joelspadin/NumBLE/case/renders/keyboard-layout.png

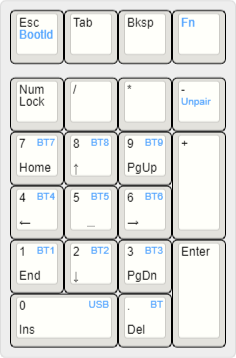
case/renders/keyboard-layout.png
