joelspadin/NumBLE/case/Case Bottom.stl

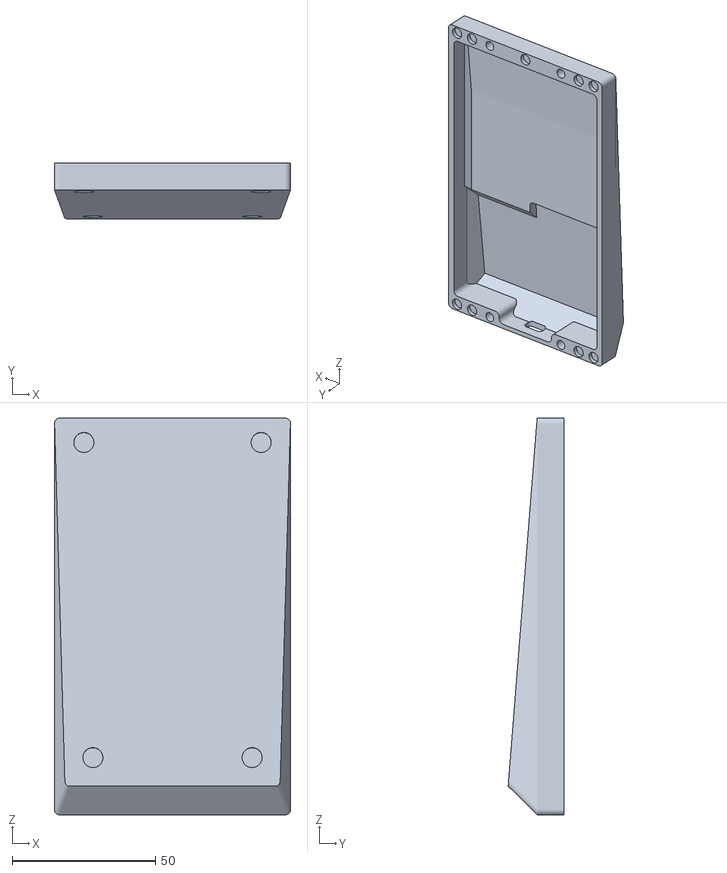
[picture p5: CAD file, 2021-05-31]
case/Case Bottom.stl
82.3 x 19.4 x 138.4
