joelspadin/NumBLE/case/Case Top.stl

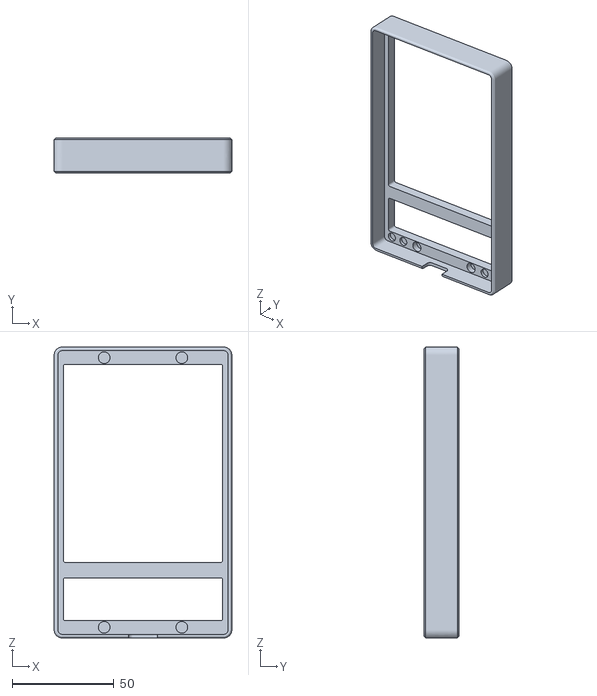
[picture p6: CAD file, 2021-05-31]
case/Case Top.stl
87.2 x 17.0 x 142.8
