joelspadin/NumBLE/case/Plate.dxf

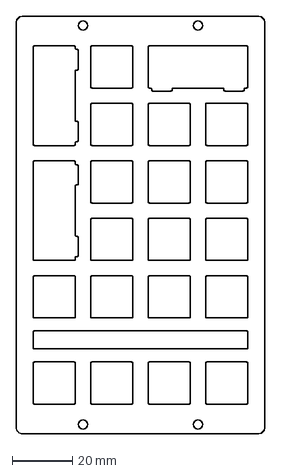
[picture p7: CAD file, 2021-05-31]
case/Plate.dxf
82.3 x 138.4 mm
