joelspadin/NumBLE/pcb/NumBLE.kicad_pcb

## KiCad design pcb/NumBLE.kicad_pcb (2021-05-31)

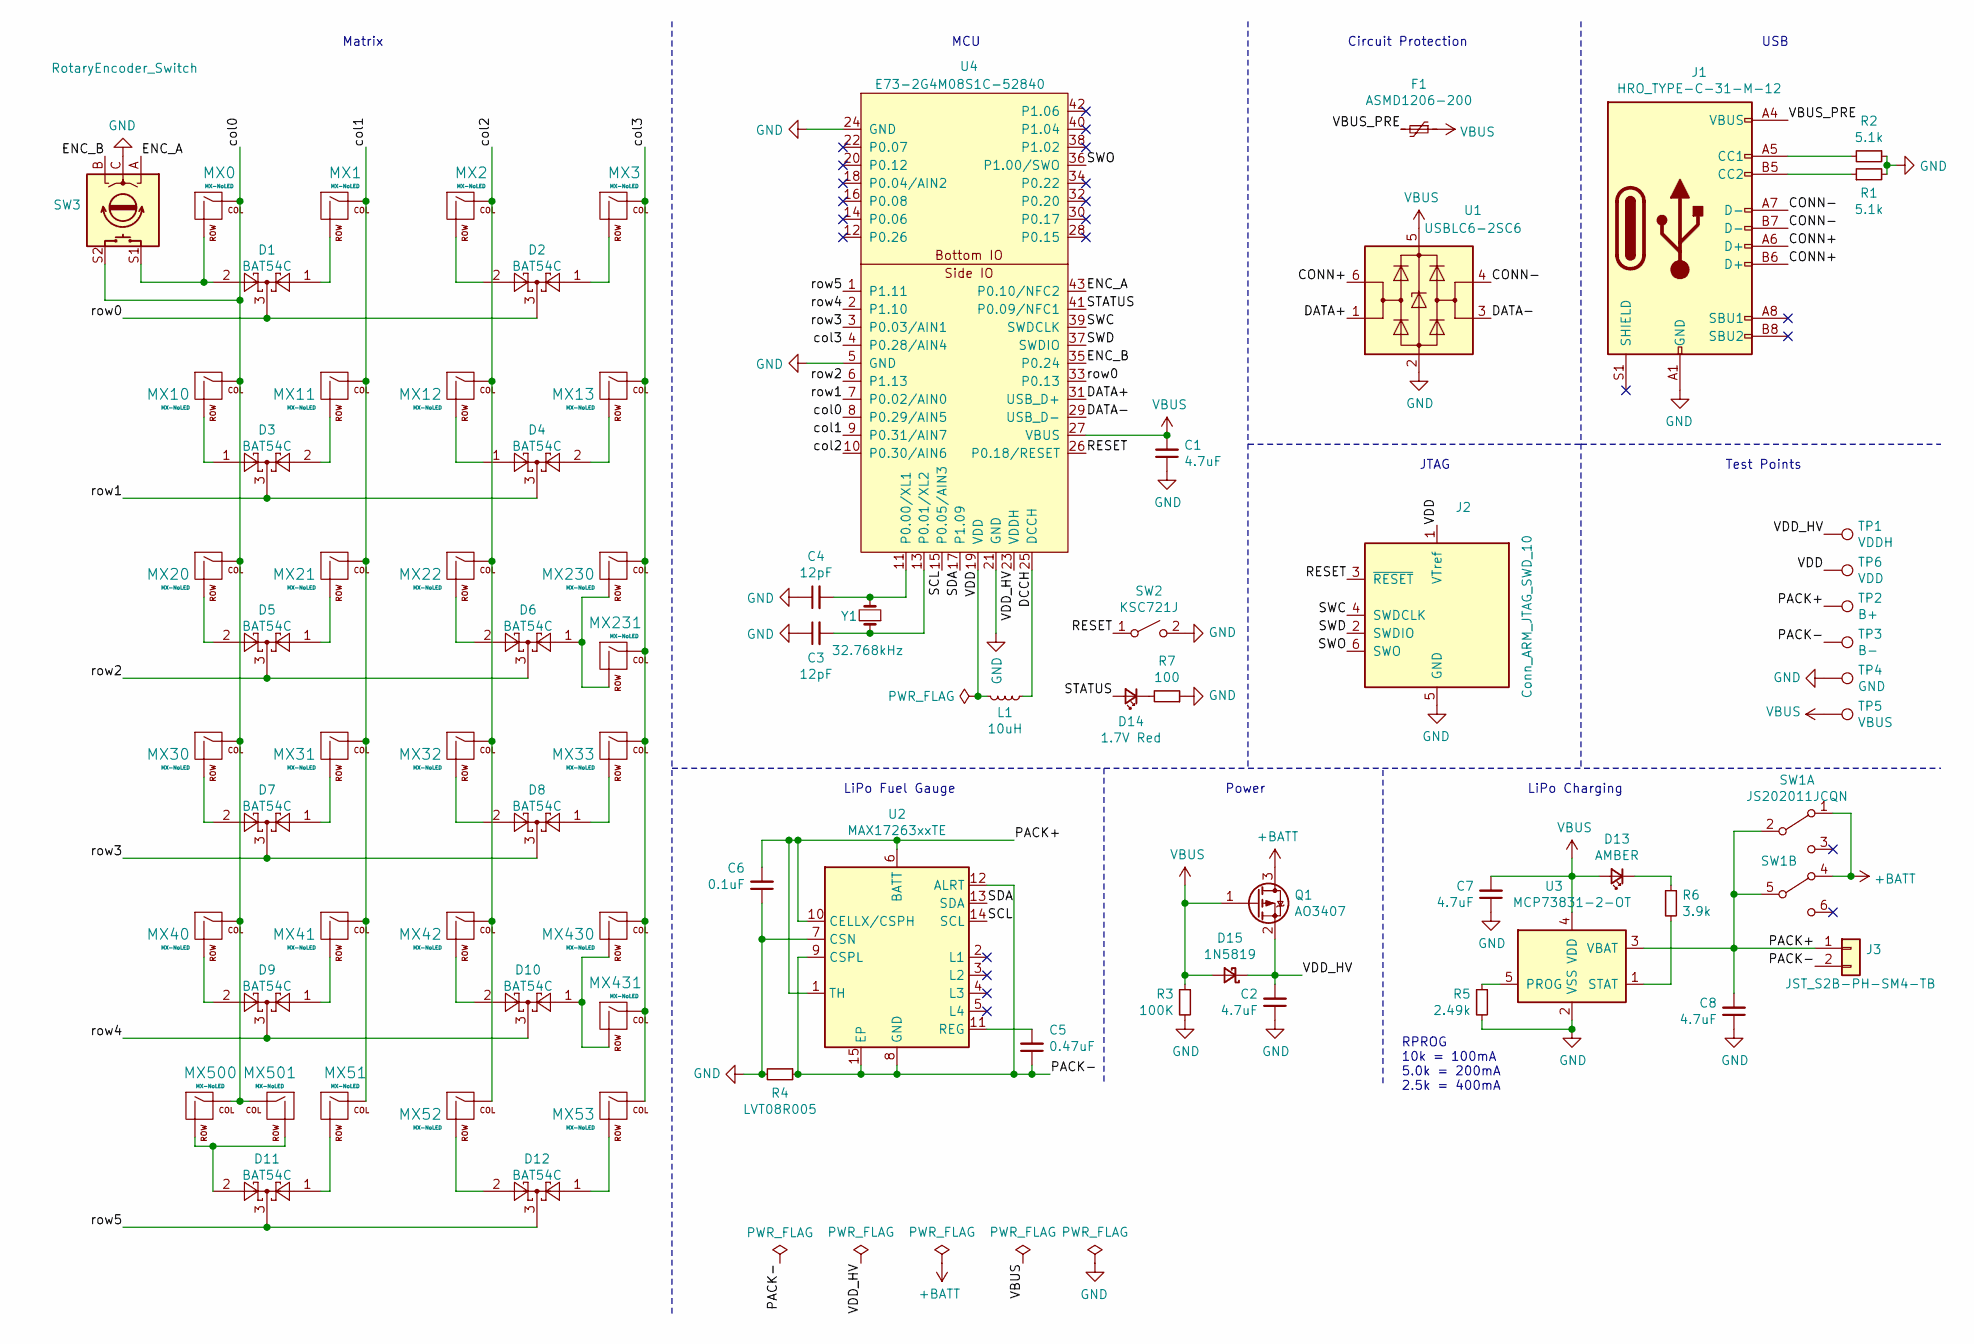
[picture p8: schematic NumBLE.kicad_sch]

Parts:
C1, C2, C7, C8: 4.7uF; C_0603_1608Metric_Pad1.08x0.95mm_HandSolder
C3, C4: 12pF; C_0603_1608Metric_Pad1.08x0.95mm_HandSolder
C5: 0.47uF; C_0603_1608Metric_Pad1.08x0.95mm_HandSolder
C6: 0.1uF; C_0603_1608Metric_Pad1.08x0.95mm_HandSolder
D1, D2, D3, D4, D5, D6, D7, D8, D9, D10, D11, D12: BAT54C; SOT-23
D13: AMBER; LED_0603_1608Metric
D14: 1.7V Red; LED_0603_1608Metric
D15: 1N5819; D_SOD-323_HandSoldering
F1: ASMD1206-200; Fuse_0805_2012Metric_Pad1.15x1.40mm_HandSolder
J1: HRO_TYPE-C-31-M-12; USB_C_Receptacle_HRO_TYPE-C-31-M-12
J2: Conn_ARM_JTAG_SWD_10; Tag-Connect_TC2030-IDC-NL_2x03_P1.27mm_Vertical
J3: JST_S2B-PH-SM4-TB; JST_PH_S2B-PH-SM4-TB_1x02-1MP_P2.00mm_Horizontal
L1: 10uH; L_0603_1608Metric_Pad1.05x0.95mm_HandSolder
MX0, MX1, MX2, MX3, MX10, MX11, MX12, MX13, MX20, MX21, MX22, MX30, MX31, MX32, MX33, MX40, MX41, MX42, MX52, MX53, MX230, MX430: MX-NoLED; MXOnly-1U-NoLED
MX51: MX-NoLED; MXOnly-1U-2U-Right
MX231, MX431: MX-NoLED; MXOnly-2U-ReversedStabilizers-NoLED
MX500: MX-NoLED; MXOnly-1U-2U-Left
MX501: MX-NoLED; MXOnly-1U-2U-Center-ReversedStabilizers
Q1: AO3407; SOT-23
R1, R2: 5.1k; R_0603_1608Metric_Pad0.98x0.95mm_HandSolder
R3: 100K; R_0603_1608Metric_Pad0.98x0.95mm_HandSolder
R4: LVT08R005; LVT08Rxxx0xER
R5: 2.49k; R_0603_1608Metric_Pad0.98x0.95mm_HandSolder
R6: 3.9k; R_0603_1608Metric_Pad0.98x0.95mm_HandSolder
R7: 100; R_0603_1608Metric_Pad0.98x0.95mm_HandSolder
SW1: JS202011JCQN; SW_DPDT_CK_JS202011JCQN
SW2: KSC721J; SW_Push_1P1T_NO_CK_KSC7xxJ
SW3: RotaryEncoder_Switch; RotaryEncoder_Alps_EC11E-Switch_Vertical_H20mm
TP1: VDDH; TestPoint_Pad_D1.5mm
TP2: B+; TestPoint_Pad_D1.5mm
TP3: B-; TestPoint_Pad_D1.5mm
TP4: GND; TestPoint_Pad_D1.5mm
TP5: VBUS; TestPoint_Pad_D1.5mm
TP6: VDD; TestPoint_Pad_D1.5mm
U1: USBLC6-2SC6; SOT-23-6
U2: MAX17263xxTE; DFN-14-1EP_3x3mm_P0.4mm_EP1.78x2.35mm
U3: MCP73831-2-OT; SOT-23-5
U4: E73-2G4M08S1C-52840
Y1: 32.768kHz; Crystal_SMD_3215-2Pin_3.2x1.5mm

Connections:
+BATT: Q1.3 (D), SW1.1 (A), SW1.4 (A)
/CONN+: J1.A6 (D+), J1.B6 (D+), U1.6 (I/O1)
/CONN-: J1.A7 (D-), J1.B7 (D-), U1.4 (I/O2)
/DATA+: U1.1 (I/O1), U4.31 (USB_D+)
/DATA-: U1.3 (I/O2), U4.29 (USB_D-)
/DCCH: L1.1, U4.25 (DCCH)
/ENC_A: SW3.A, U4.43 (P0.10/NFC2)
/ENC_B: SW3.B, U4.35 (P0.24)
/PACK+: C6.2, C8.2, J3.1, SW1.2 (B), SW1.5 (B), TP2.1, U2.1 (TH), U2.6 (BATT), U2.10 (CELLX/CSPH), U3.3 (VBAT)
/PACK-: C5.1, J3.2, R4.1, TP3.1, U2.8 (GND), U2.9 (CSPL), U2.12 (ALRT), U2.15 (EP)
/RESET: J2.3 (~RESET~), SW2.1 (A), U4.26 (P0.18/RESET)
/SCL: U2.14 (SCL), U4.15 (P0.05/AIN3)
/SDA: U2.13 (SDA), U4.17 (P1.09)
/STATUS: D14.2 (A), U4.41 (P0.09/NFC1)
/SWC: J2.4 (SWDCLK), U4.39 (SWDCLK)
/SWD: J2.2 (SWDIO), U4.37 (SWDIO)
/SWO: J2.6 (SWO), U4.36 (P1.00/SWO)
/VBUS_PRE: F1.2, J1.A4 (VBUS), J1.A9 (VBUS), J1.B4 (VBUS), J1.B9 (VBUS)
/VDD: J2.1 (VTref), L1.2, TP6.1, U4.19 (VDD)
/VDD_HV: C2.2, D15.1 (K), Q1.2 (S), TP1.1, U4.23 (VDDH)
/col0: MX0.1 (COL), MX10.1 (COL), MX20.1 (COL), MX30.1 (COL), MX40.1 (COL), MX500.1 (COL), MX501.1 (COL), SW3.S2, U4.8 (P0.29/AIN5)
/col1: MX1.1 (COL), MX11.1 (COL), MX21.1 (COL), MX31.1 (COL), MX41.1 (COL), MX51.1 (COL), U4.9 (P0.31/AIN7)
/col2: MX2.1 (COL), MX12.1 (COL), MX22.1 (COL), MX32.1 (COL), MX42.1 (COL), MX52.1 (COL), U4.10 (P0.30/AIN6)
/col3: MX3.1 (COL), MX13.1 (COL), MX33.1 (COL), MX53.1 (COL), MX230.1 (COL), MX231.1 (COL), MX430.1 (COL), MX431.1 (COL), U4.4 (P0.28/AIN4)
/row0: D1.3, D2.3, U4.33 (P0.13)
/row1: D3.3, D4.3, U4.7 (P0.02/AIN0)
/row2: D5.3, D6.3, U4.6 (P1.13)
/row3: D7.3, D8.3, U4.3 (P0.03/AIN1)
/row4: D9.3, D10.3, U4.2 (P1.10)
/row5: D11.3, D12.3, U4.1 (P1.11)
GND: C1.1, C2.1, C3.1, C4.1, C6.1, C7.1, C8.1, J1.A1 (GND), J1.A12 (GND), J1.B1 (GND), J1.B12 (GND), J2.5 (GND), R1.2, R2.1, R3.2, R4.2, R5.2, R7.1, SW2.2 (B), SW3.C, TP4.1, U1.2 (GND), U2.7 (CSN), U3.2 (VSS), U4.5 (GND), U4.21 (GND), U4.24 (GND)
unnamed: C3.2, U4.13 (P0.01/XL2), Y1.1
unnamed: C4.2, U4.11 (P0.00/XL1), Y1.2
unnamed: C5.2, U2.11 (REG)
unnamed: D1.1, MX1.2 (ROW)
unnamed: D1.2, MX0.2 (ROW), SW3.S1
unnamed: D2.1, MX3.2 (ROW)
unnamed: D2.2, MX2.2 (ROW)
unnamed: D3.1, MX10.2 (ROW)
unnamed: D3.2, MX11.2 (ROW)
unnamed: D4.1, MX12.2 (ROW)
unnamed: D4.2, MX13.2 (ROW)
unnamed: D5.1, MX21.2 (ROW)
unnamed: D5.2, MX20.2 (ROW)
unnamed: D6.1, MX230.2 (ROW), MX231.2 (ROW)
unnamed: D6.2, MX22.2 (ROW)
unnamed: D7.1, MX31.2 (ROW)
unnamed: D7.2, MX30.2 (ROW)
unnamed: D8.1, MX33.2 (ROW)
unnamed: D8.2, MX32.2 (ROW)
unnamed: D9.1, MX41.2 (ROW)
unnamed: D9.2, MX40.2 (ROW)
unnamed: D10.1, MX430.2 (ROW), MX431.2 (ROW)
unnamed: D10.2, MX42.2 (ROW)
unnamed: D11.1, MX51.2 (ROW)
unnamed: D11.2, MX500.2 (ROW), MX501.2 (ROW)
unnamed: D12.1, MX53.2 (ROW)
unnamed: D12.2, MX52.2 (ROW)
unnamed: D13.1 (K), R6.1
unnamed: D14.1 (K), R7.2
unnamed: J1.A5 (CC1), R2.2
unnamed: J1.B5 (CC2), R1.1
unnamed: R5.1, U3.5 (PROG)
unnamed: R6.2, U3.1 (STAT)
VBUS: C1.2, C7.2, D13.2 (A), D15.2 (A), F1.1, Q1.1 (G), R3.1, TP5.1, U1.5 (VBUS), U3.4 (VDD), U4.27 (VBUS)

Notes on the sheet:
Matrix
LiPo Fuel Gauge
MCU
Power
Circuit Protection
RPROG 10k = 100mA 5.0k = 200mA 2.5k = 400mA
JTAG
LiPo Charging
Test Points
USB

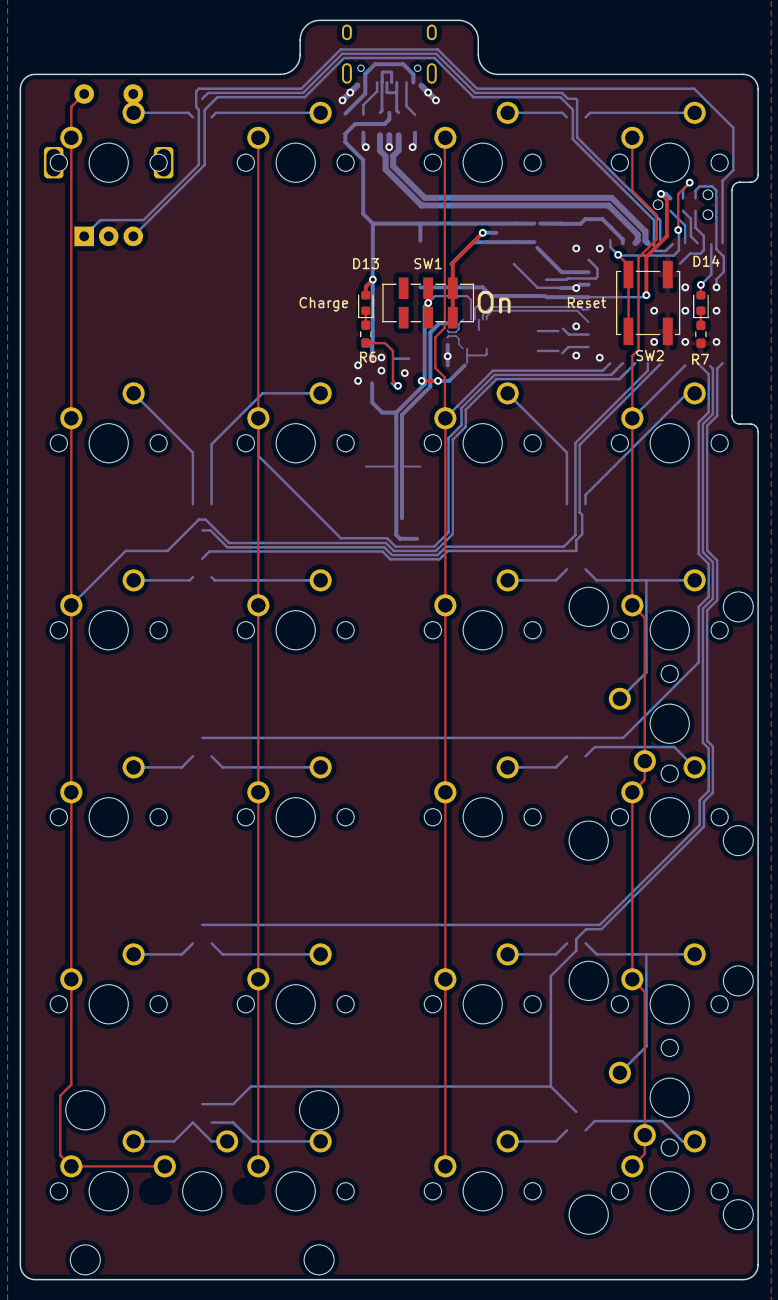
[picture p9: board NumBLE.kicad_pcb from above]

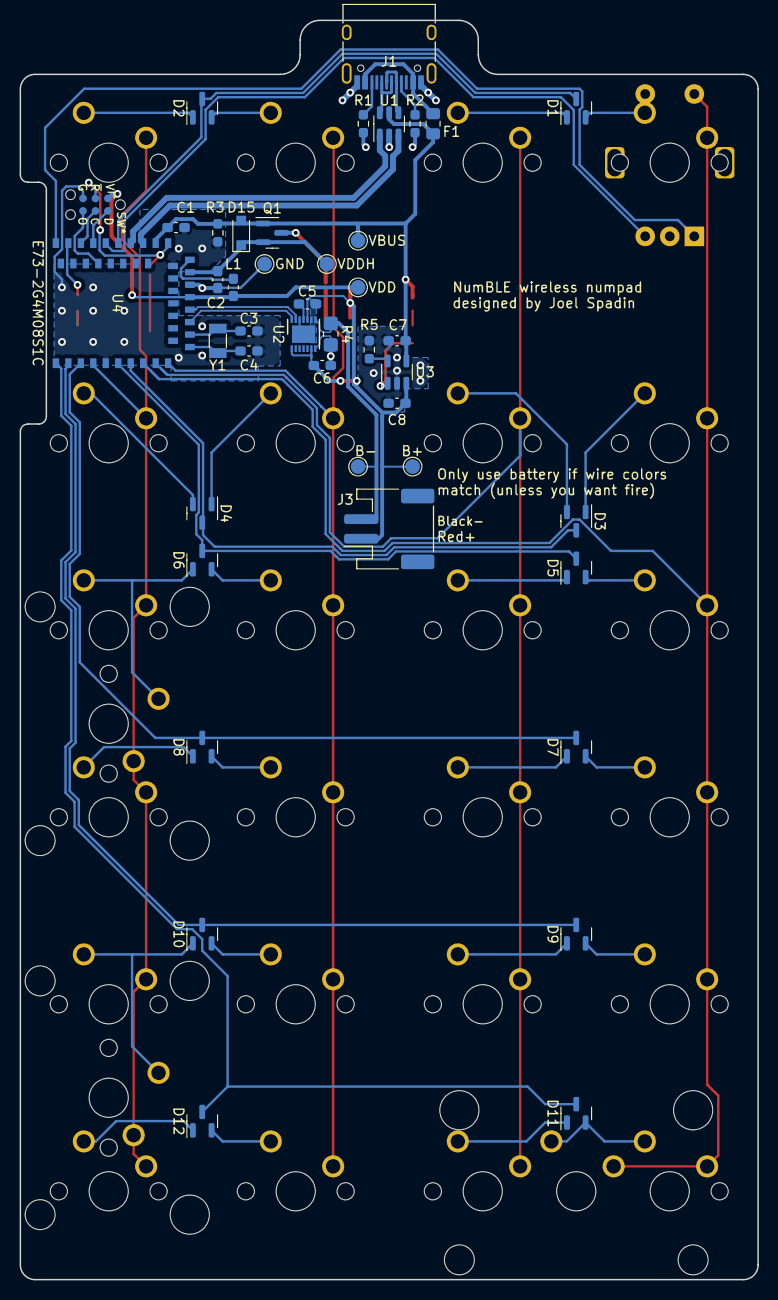
[picture p10: board NumBLE.kicad_pcb from below]

Board: 2 copper layers, 75.2 x 128.3 mm, 77 parts (43 on the bottom side), 65 nets.
