joelspadin/NumBLE/case/renders/Assembly-Bottom.gif

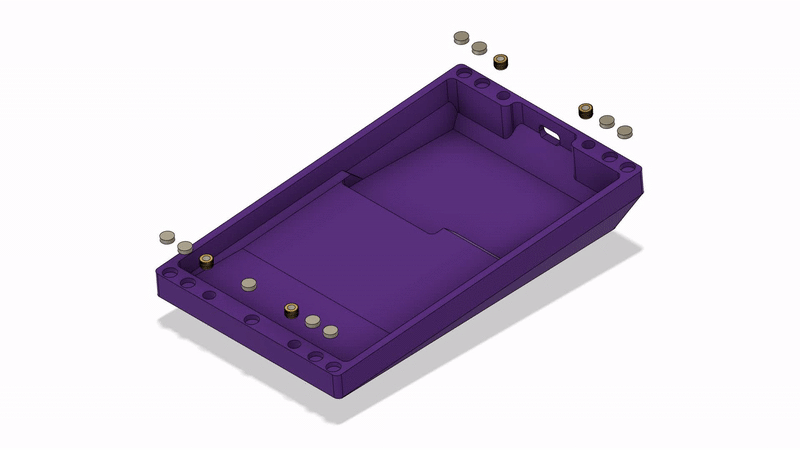
case/renders/Assembly-Bottom.gif
