joelspadin/NumBLE/case/renders/Assembly-Bumpons.gif

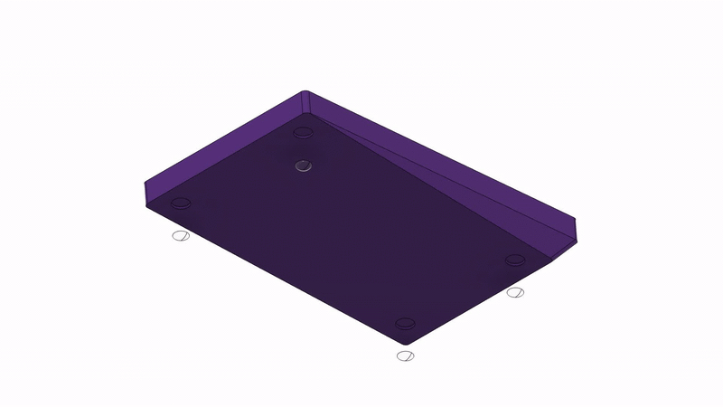
case/renders/Assembly-Bumpons.gif
