joelspadin/NumBLE/case/renders/Assembly-Switches.gif

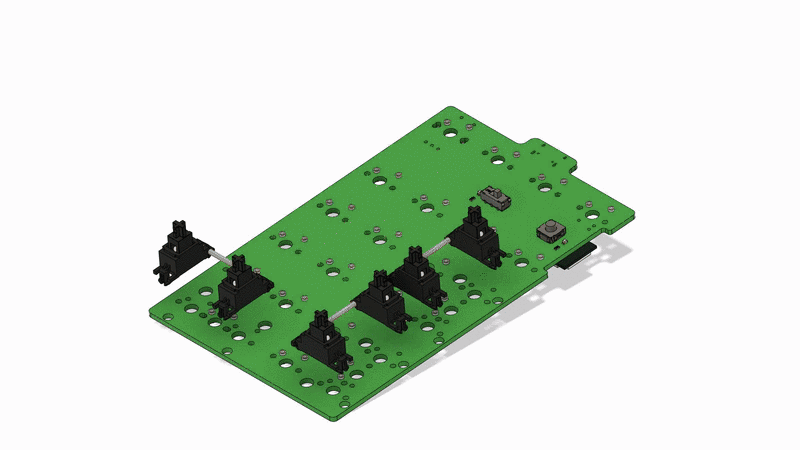
case/renders/Assembly-Switches.gif
