joelspadin/NumBLE/case/renders/Assembly-Top.gif

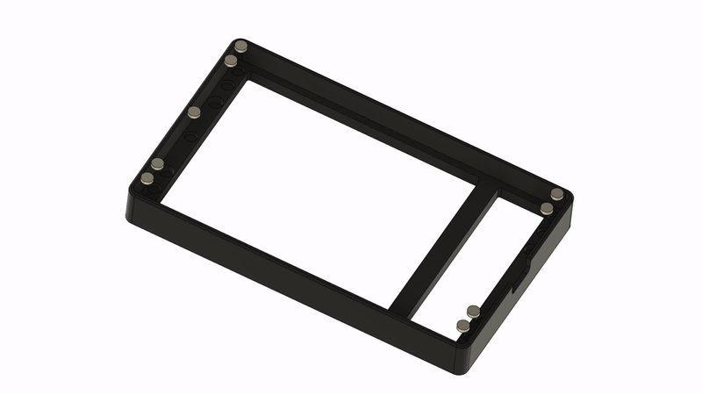
case/renders/Assembly-Top.gif
