joelspadin/NumBLE/(commit log)

2021-05-31 Move PCB files into subdirectory
    [NumBLE.kicad_pcb, NumBLE.kicad_sch]
2021-05-31 Add case files
    [Case Bottom.stl, Case Top.stl, Plate.dxf]
2021-05-31 Fix resistor numbering
    [NumBLE.kicad_pcb, NumBLE.kicad_sch]
2021-06-01 Add title block to schematic
    [NumBLE.kicad_sch]
2021-06-06 Add assembly animations
2021-07-04 Fix encoder typo
2021-07-31 Enable VDDH battery driver by default
2022-03-14 Remove settings_reset build
    settings_reset shield doesn't work with custom boards.
2022-04-03 Switch to stable Zephyr 3.0 branch
2022-04-10 Fix battery reporting until chosen node supported
    Changed the battery sensor's label to "BATTERY" so the existing battery
    code in ZMK will pick it up while the PR to add a battery chosen node
    is still in review.
2023-10-13 Use kconfig to enable high voltage DC-DC
2024-03-09 Update numble board definition
    Added support for UF2 flash runner.
    Removed deprecated labels.
    Removed unnecessary config values.
